damienmaguire/DC-Motor-Controller/Simple_DC_v1_bom.ods

Simple DC Controller V1
Ref Name | Qty | Component | Value | Manufacturer | MPN | RS Part Number | Mouser Part Number | Description
D2,3,4,5 | 4 | 1N4148W-7-F |  | Diodes Inc. | 1N4148W-7-F | 7384728P |  | Diode Switching 150mA 100V 400mW SOD123 Diodes Inc 1N4148W-7-F Switching Diode 100V, 2-Pin SOD-123
CONN1 | 1 | 4tb |  | TE Connectivity | 282834-4 | 909-7615 |  | 2.54mm Pitch, 4 Way Vertical, PCB Terminal Block, PCB Mount
CONN2 | 1 | 10TB |  | Phoenix Contact | 1725737 | 220-4355 |  | 2.54mm Pitch, 10 Way Straight, PCB Terminal Block, Through Hole
IC4 | 1 | 74LVC1G3157GV-Q10H |  | Nexperia | 74LVC1G3157GV-Q10H |  | 771-74LVC1G3157GVQ10 | Multiplexer Switch ICs 74LVC1G3157GV-Q100/SC-74/REEL
C3,11 | 2 | Cap_el | 47uF | Wurth Elektronik | 860240473003 | 839-6211 |  | Aluminium Electrolytic Capacitor WCAP-AT1H Series 25V dc 47μF, Through Hole Electrolytic, ±20%
C1,2,4,6,8 | 5 | C_0805 | 0.1uF |  |  |  |  | Standard 0805 mlcc cap 50v
C7 | 1 | C_0805 | 1n |  |  |  |  | Standard 0805 mlcc cap 50v
C5 | 1 | C_0805 | 22n |  |  |  |  | Standard 0805 mlcc cap 50v
C9,10 | 2 | C_0805 | 47n |  |  |  |  | Standard 0805 mlcc cap 50v
LED1 | 1 | LED0805 |  |  |  |  |  | Any 0805 red or green chip led
IC1 | 1 | LTC6992CS6-1#TRMPBF |  | Linear Technology | LTC6992CS6-1#TRMPBF | 1456265 |  | LTC6992,Silicon Oscillator,PWM,TSOT23-6 LTC6992CS6-1#TRMPBF, Silicon Oscillator, 1MHz, 6-Pin TSOT-23
D1 | 1 | MBRS540T3G |  | ON Semiconductor | MBRS540T3G | 1250012 |  | Diode Schottky 40V 5A SMC ON Semiconductor MBRS540T3G Schottky Diode, 5A, 40V, 2-Pin SMC
IC3 | 1 | MCP6561T-E_LT |  | Microchip | MCP6561T-E/LT | 6878405P |  | Single 1.8V Push/Pull Comparator, E temp
Q1 | 1 | MMBT3904 |  | Fairchild Semiconductor | MMBT3904 | 7390303 |  | Transistor GP BJT NPN 40V 0.2A SOT23 Fairchild MMBT3904 NPN Bipolar Transistor, 0.2 A, 40 V, 3-Pin SOT-23
R6,11,12,14 | 4 | R-US_R0805 | 1K |  |  |  |  | Standard 0805 .1% chip resistor 100v
R13 | 1 | R-US_R0805 | 2K2 |  |  |  |  | Standard 0805 .1% chip resistor 100v
R8,9 | 2 | R-US_R0805 | 22K |  |  |  |  | Standard 0805 .1% chip resistor 100v
R1,2 | 2 | R-US_R0805 | 47K |  |  |  |  | Standard 0805 .1% chip resistor 100v
R7 | 1 | R-US_R0805 | 150K |  |  |  |  | Standard 0805 .1% chip resistor 100v
R5 | 1 | R-US_R0805 | 182K |  |  |  |  | Standard 0805 .1% chip resistor 100v
R3 | 1 | R-US_R0805 | 392K |  |  |  |  | Standard 0805 .1% chip resistor 100v
R10 | 1 | R-US_R0805 | 680R |  |  |  |  | Standard 0805 .1% chip resistor 100v
R4 | 1 | R-US_R0805 | 976K |  |  |  |  | Standard 0805 .1% chip resistor 100v
IC2 | 1 | TR10S05 |  | XP POWER | TR10S05 | 1346949 |  | XP Power Switching Regulator, 8 28V dc Input, 5V dc Output, 1A
