damienmaguire/DC-Motor-Controller/DC_igbt_v1_BOM.ods

DC TWIN IGBT DRIVER V1
Ref Name | Qty | Component | Value | Package | Manufacturer | MPN | RS Part Number | Description
ZD1,ZD2,ZD3,ZD4 | 4 | 1N5353BG |  | DIOAD2260W109L864D349 | ON Semiconductor | 1N5353BG |  | ON SEMICONDUCTOR - 1N5353BG - DIODE, ZENER, 16V, 5W
CONN1 | 1 | 3way_tb |  | DSC |  |  |  | 3 WAY 5MM PITCH SCREW TERMINAL
IC1 | 1 | ACNW3190-000E |  | DIP1016W56P254L1115H561Q8N | Avago Technologies | ACNW3190-000E | 7160613 | IGBT Gate Driver Optocoupler, DIP8 Avago ACNW3190-000E DC Input Optocoupler, Through Hole, 8-Pin PDIP-W
C1,C5 | 2 | C320C104K5R5TA | 100nF | C320C | Kemet | C320C104K5R5TA | 5381310A | Radial X7R ceramic cap,100nF 50V 2.5mm Kemet Radial C 100nF Ceramic Multilayer Capacitor, 50 V dc, +125degC, X7R Dielectric, /-10%
C2,C3,C4 | 3 | CPOL-EUE2,5-6E | 100µ | E2,5-6E |  |  |  | 100uF 25V ELEC CAP
LED1 | 1 | LED (3mm) |  | DIL |  |  |  | 3MM LED
U1 | 1 | MGJ2D051505SC |  | MGJ2D051505SC | Murata Electronics | MGJ2D051505SC | 8163493 | DC/DC Converter Isolated 15/-5V 80/40mA Murata Power Solutions Isolated DC-DC Converter, Vin 4.5 5.5 V dc, Vout -5 V, 15 V, I/O isolation 5200V dc
R3,4 | 2 | Resistor2 | 1K | DSC |  |  |  | 0.25W CARBON
R5 | 1 | Resistor2 | 270R | DSC |  |  |  | 0.25W CARBON
R6 | 1 | Resistor2 | 470R | DSC |  |  |  | 0.25W CARBON
R1,R2,R7,R8 | 4 | RES_2W | 22R | DSC |  |  |  | 2WATT RESISTOR
D1,D2 | 2 | UF4007TA |  | DIOAD1408W86L464D236 | SMC Diode Solutions | UF4007TA |  | ULTRA FAST RECITIFIER
