damienmaguire/DC-Motor-Controller/precharge_v1 - Schematic.pdf

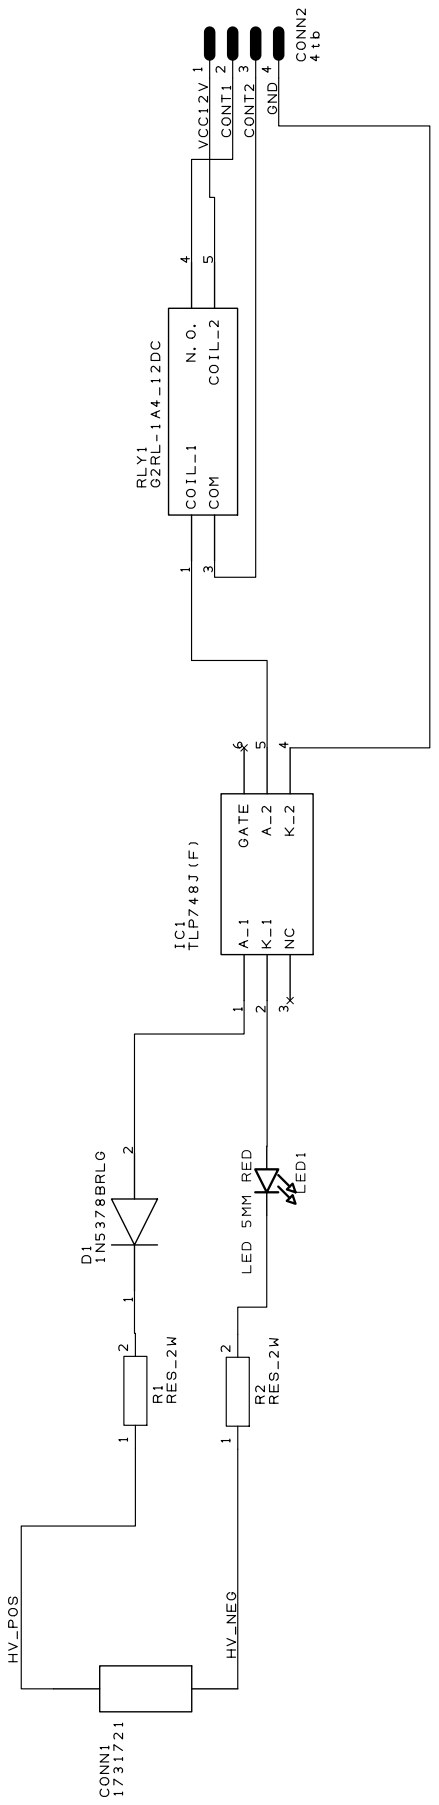
[picture p1: page 1]
