damienmaguire/DC-Motor-Controller/DC_igbt_v1 - Schematic.pdf

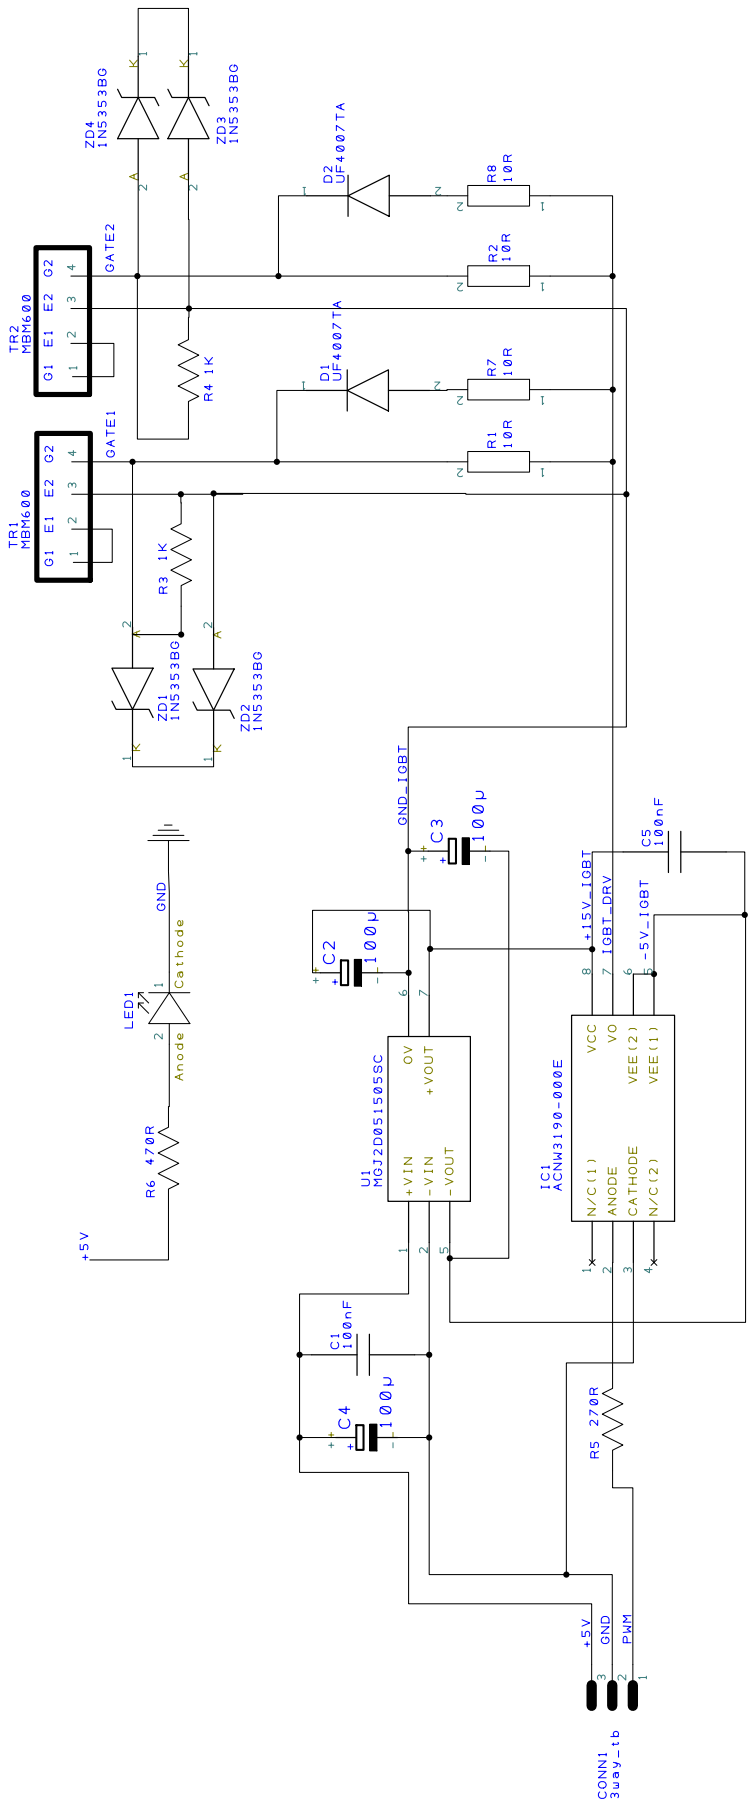
[picture p2: page 1]
