damienmaguire/DC-Motor-Controller/Simple_DC_v1 - Schematic.pdf

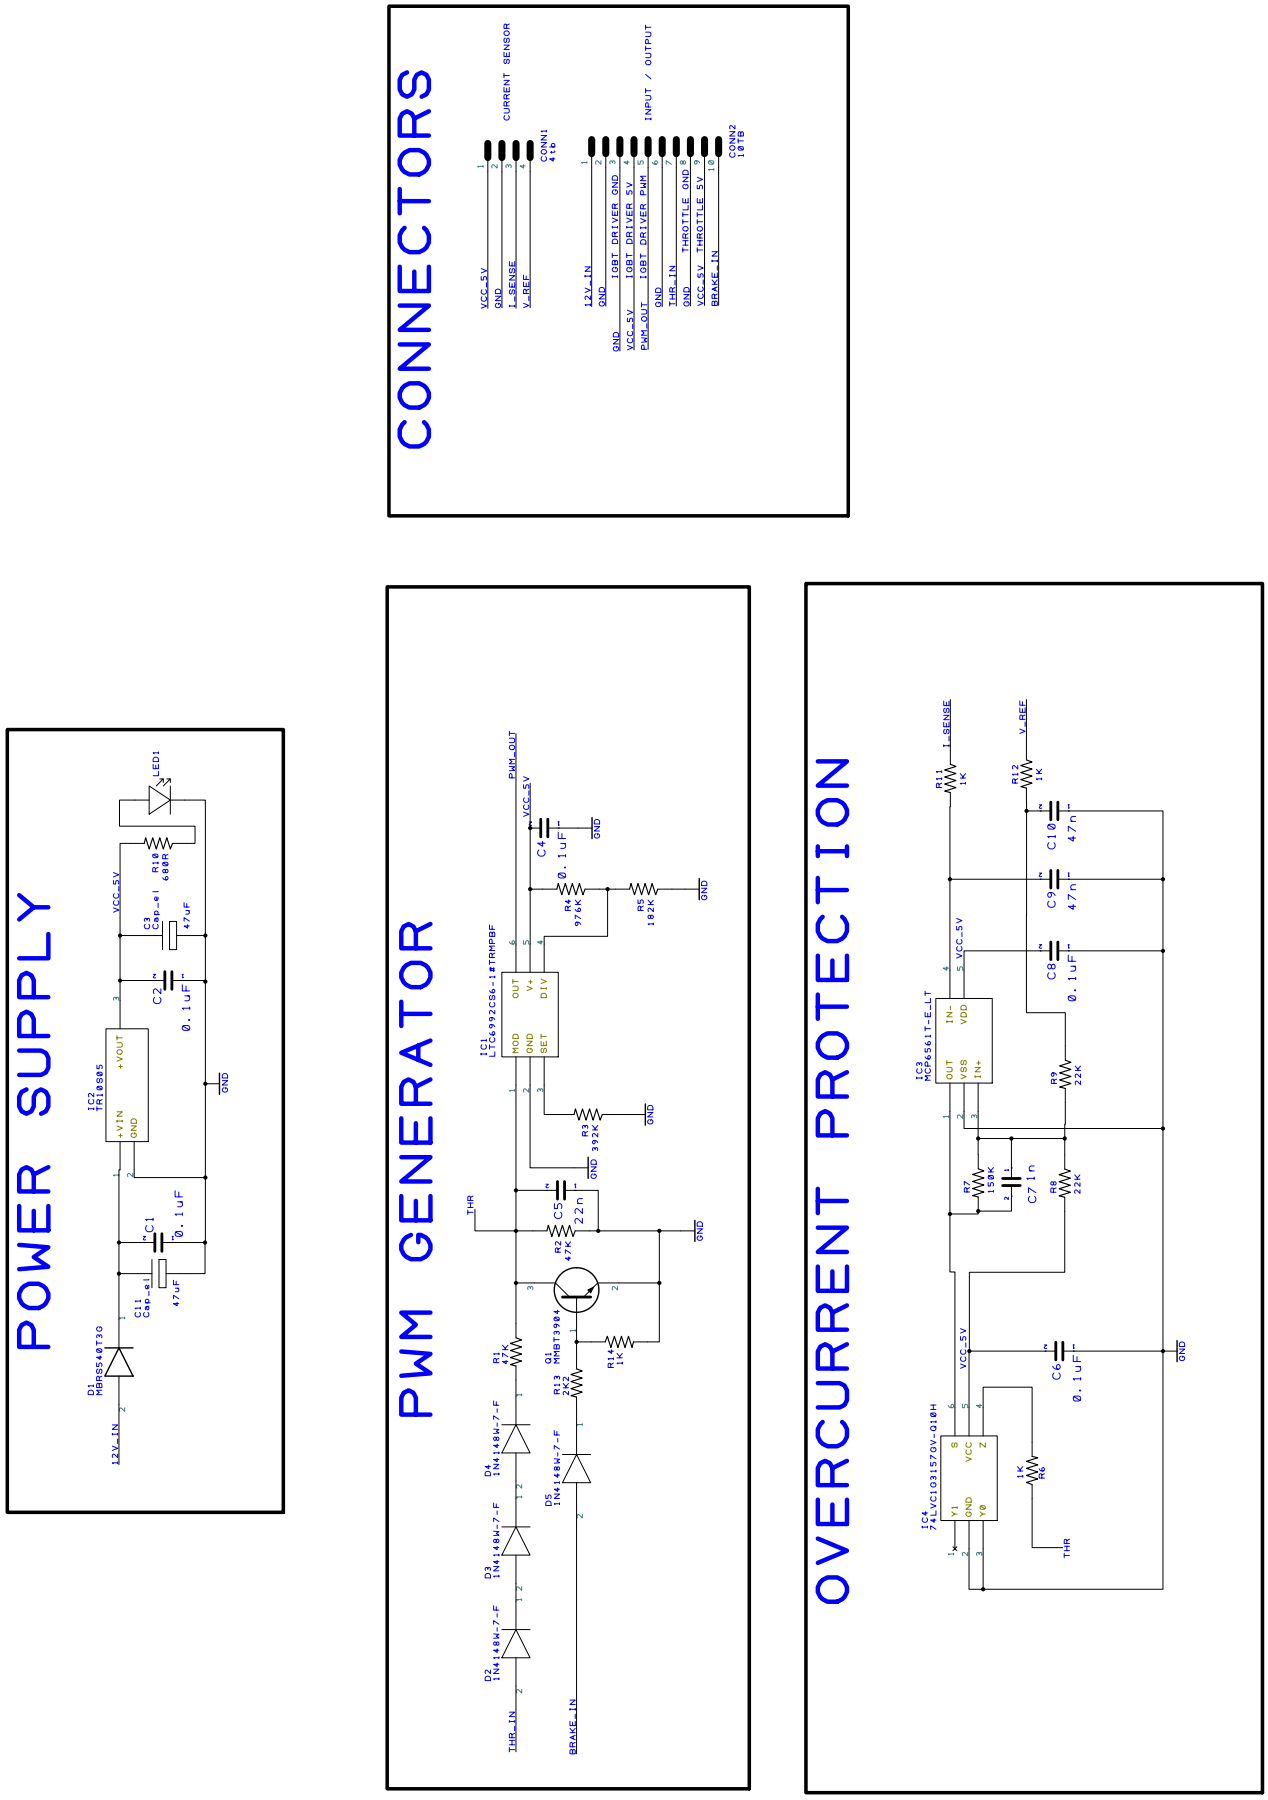
[picture p3: page 1]
