damienmaguire/DC-Motor-Controller/precharge_v1 - PCB.pdf

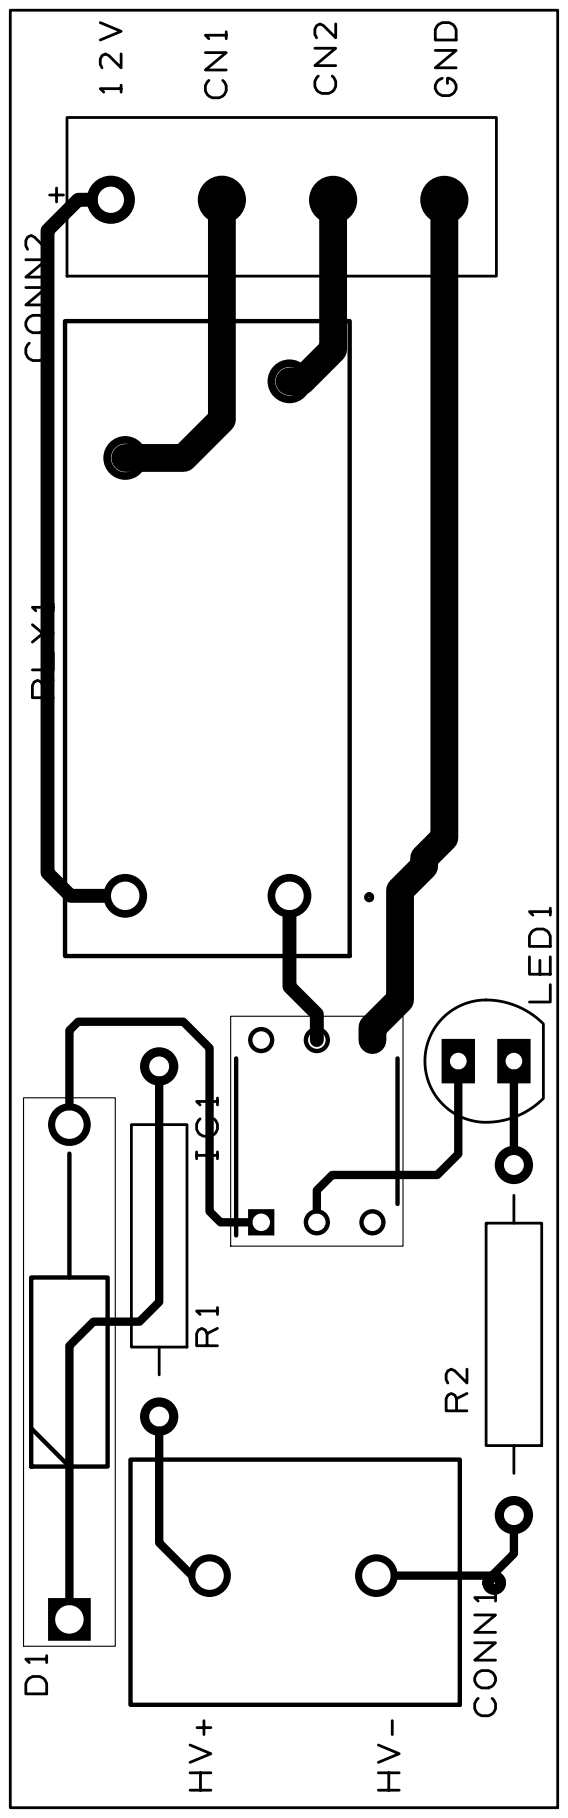
[picture p4: page 1]
