damienmaguire/DC-Motor-Controller/DC_igbt_v1 - PCB.pdf

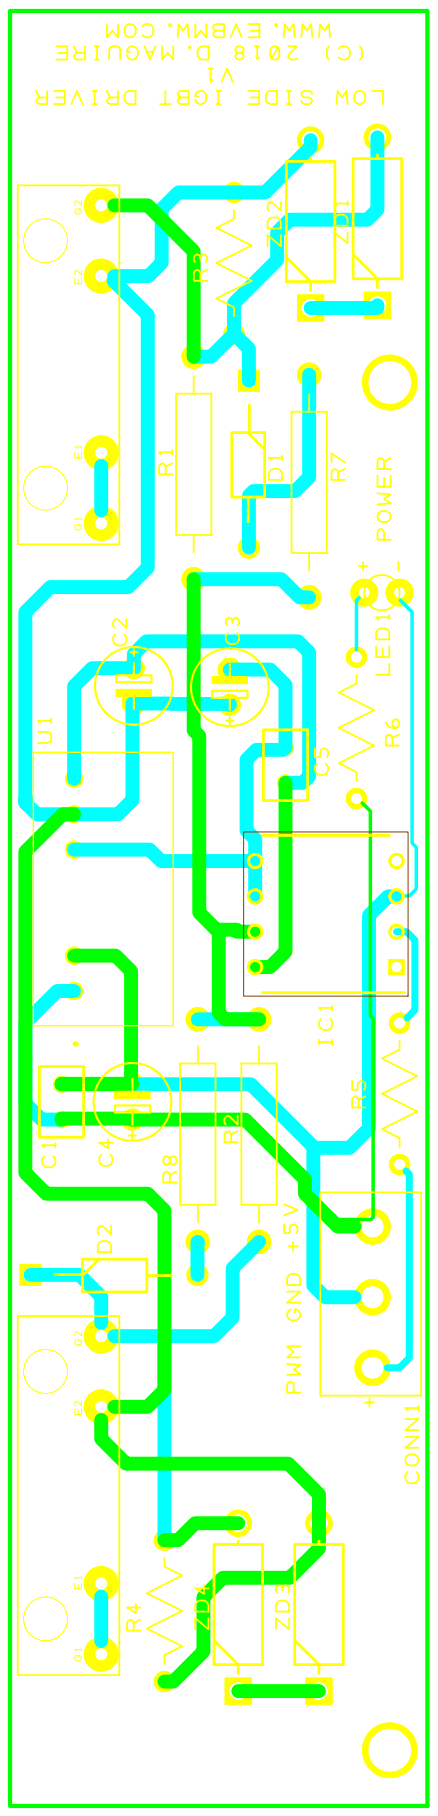
[picture p5: page 1]
