damienmaguire/DC-Motor-Controller/Simple_DC_v1 - PCB.pdf

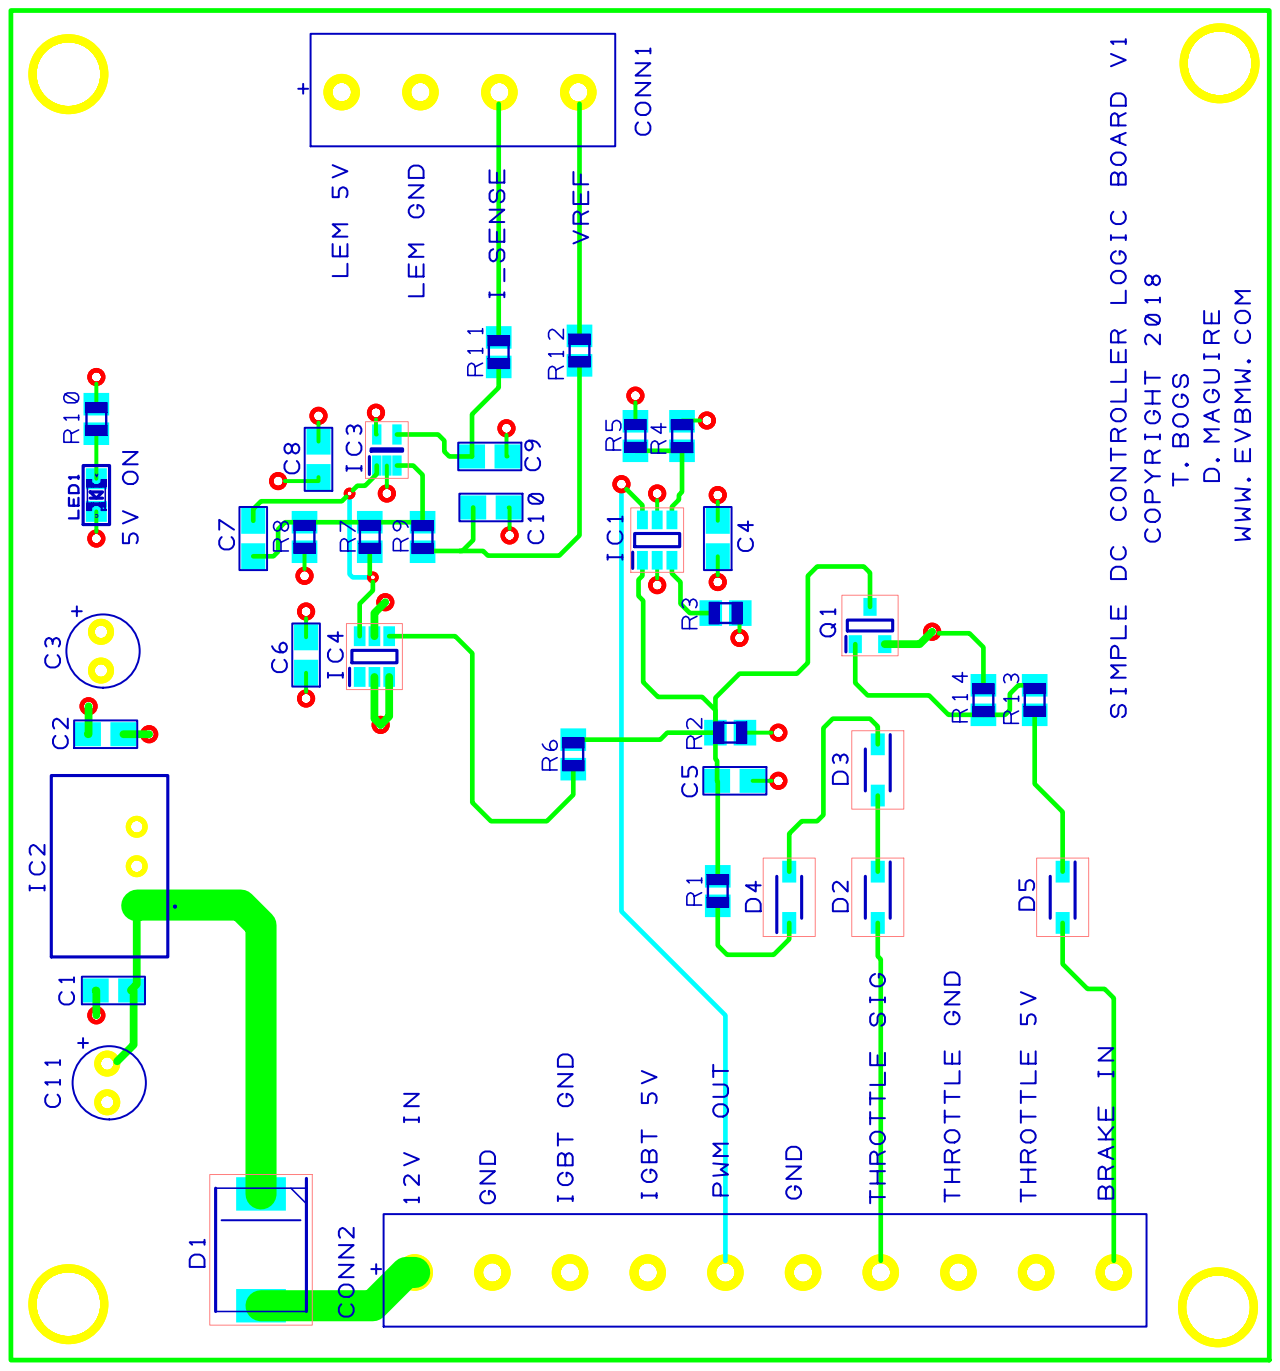
[picture p6: page 1]
