damienmaguire/DC-Motor-Controller/(list of files, drawings)

Other design files:
DC_igbt_v1.pcb
precharge_v1.pcb
Simple_DC_v1.pcb
